uditkalapurakkal/riscv-pipelined-soc-vhdl/riscv-pipelined-soc-vhdl/docs/images/layout_screenshot.png

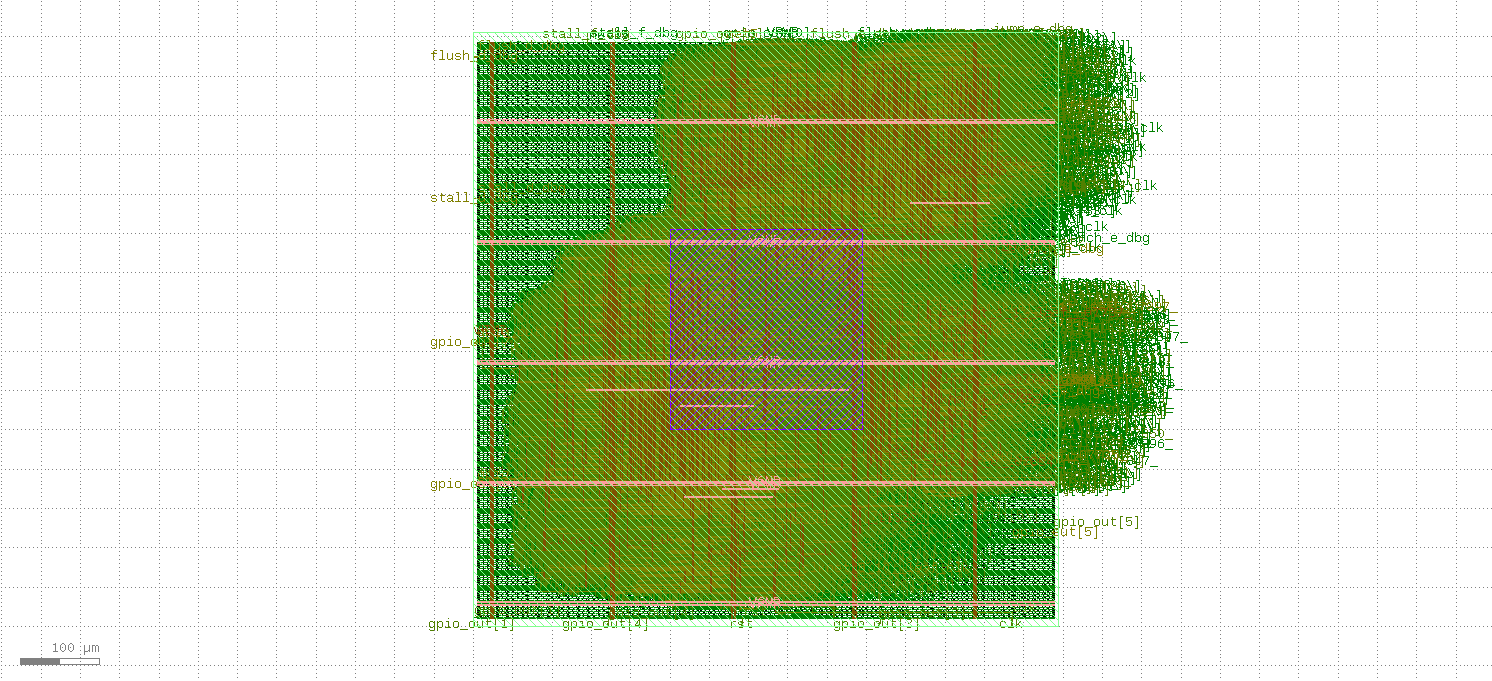
riscv-pipelined-soc-vhdl/docs/images/layout_screenshot.png
