uditkalapurakkal/riscv-pipelined-soc-vhdl/riscv-pipelined-soc-vhdl/reports/openlane/fix_cts_cluster_6/metrics.csv

design | design_name | config | flow_status | total_runtime | routed_runtime | (Cell/mm^2)/Core_Util | DIEAREA_mm^2 | CellPer_mm^2 | OpenDP_Util | Final_Util | Peak_Memory_Usage_MB | synth_cell_count | tritonRoute_violations | Short_violations | MetSpc_violations | OffGrid_violations | MinHole_violations | Other_violations | Magic_violations | pin_antenna_violations | net_antenna_violations | lvs_total_errors | cvc_total_errors | klayout_violations | wire_length | vias | wns | pl_wns | optimized_wns | fastroute_wns | spef_wns | tns | pl_tns | optimized_tns | fastroute_tns | spef_tns | HPWL | routing_layer1_pct | routing_layer2_pct | routing_layer3_pct | routing_layer4_pct | routing_layer5_pct | routing_layer6_pct | wires_count | wire_bits | public_wires_count | public_wire_bits | memories_count | memory_bits | processes_count | cells_pre_abc | AND | DFF | NAND | NOR | OR | XOR | XNOR | MUX
/home/ukm/asic_projects/riscv-pipelined-soc-vhdl/riscv-pipelined-soc-vhdl/openlane/riscv_soc | soc_top | fix_cts_cluster_6 | flow completed | 0h35m52s0ms | 0h29m32s0ms | 113959.51296703656 | 0.5542068513000001 | 39885.82953846279 | 35.88 | -1 | 2039.72 | 17159 | 0 | 0 | 0 | 0 | 0 | 0 | 0 | 24 | 22 | 0 | -1 | -1 | 739391 | 149528 | 0.0 | -1 | -1 | -1 | 0.0 | 0.0 | -1 | -1 | -1 | 0.0 | 491268174.0 | 0.0 | 37.32 | 36.55 | 11.24 | 15.45 | 0.0 | 8255 | 23750 | 1146 | 16583 | 0 | 0 | 0 | 11339 | 244 | 2 | 134 | 167 | 736 | 157 | 109 | 3192
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
