uditkalapurakkal/riscv-pipelined-soc-vhdl/riscv-pipelined-soc-vhdl/waves/BUSCHECK.pdf

0 | 1 | 2 | 4 | 8 | 1 | 2 | 4 | 8 | 1 | 2 | 4 | 8 | 1 | 2 | 4 | 8 | 1 | 2 | 4 | 8 | 1 | 2 | 4 | 8 | 1 | 2 | 4 | 8 | 1

# clk

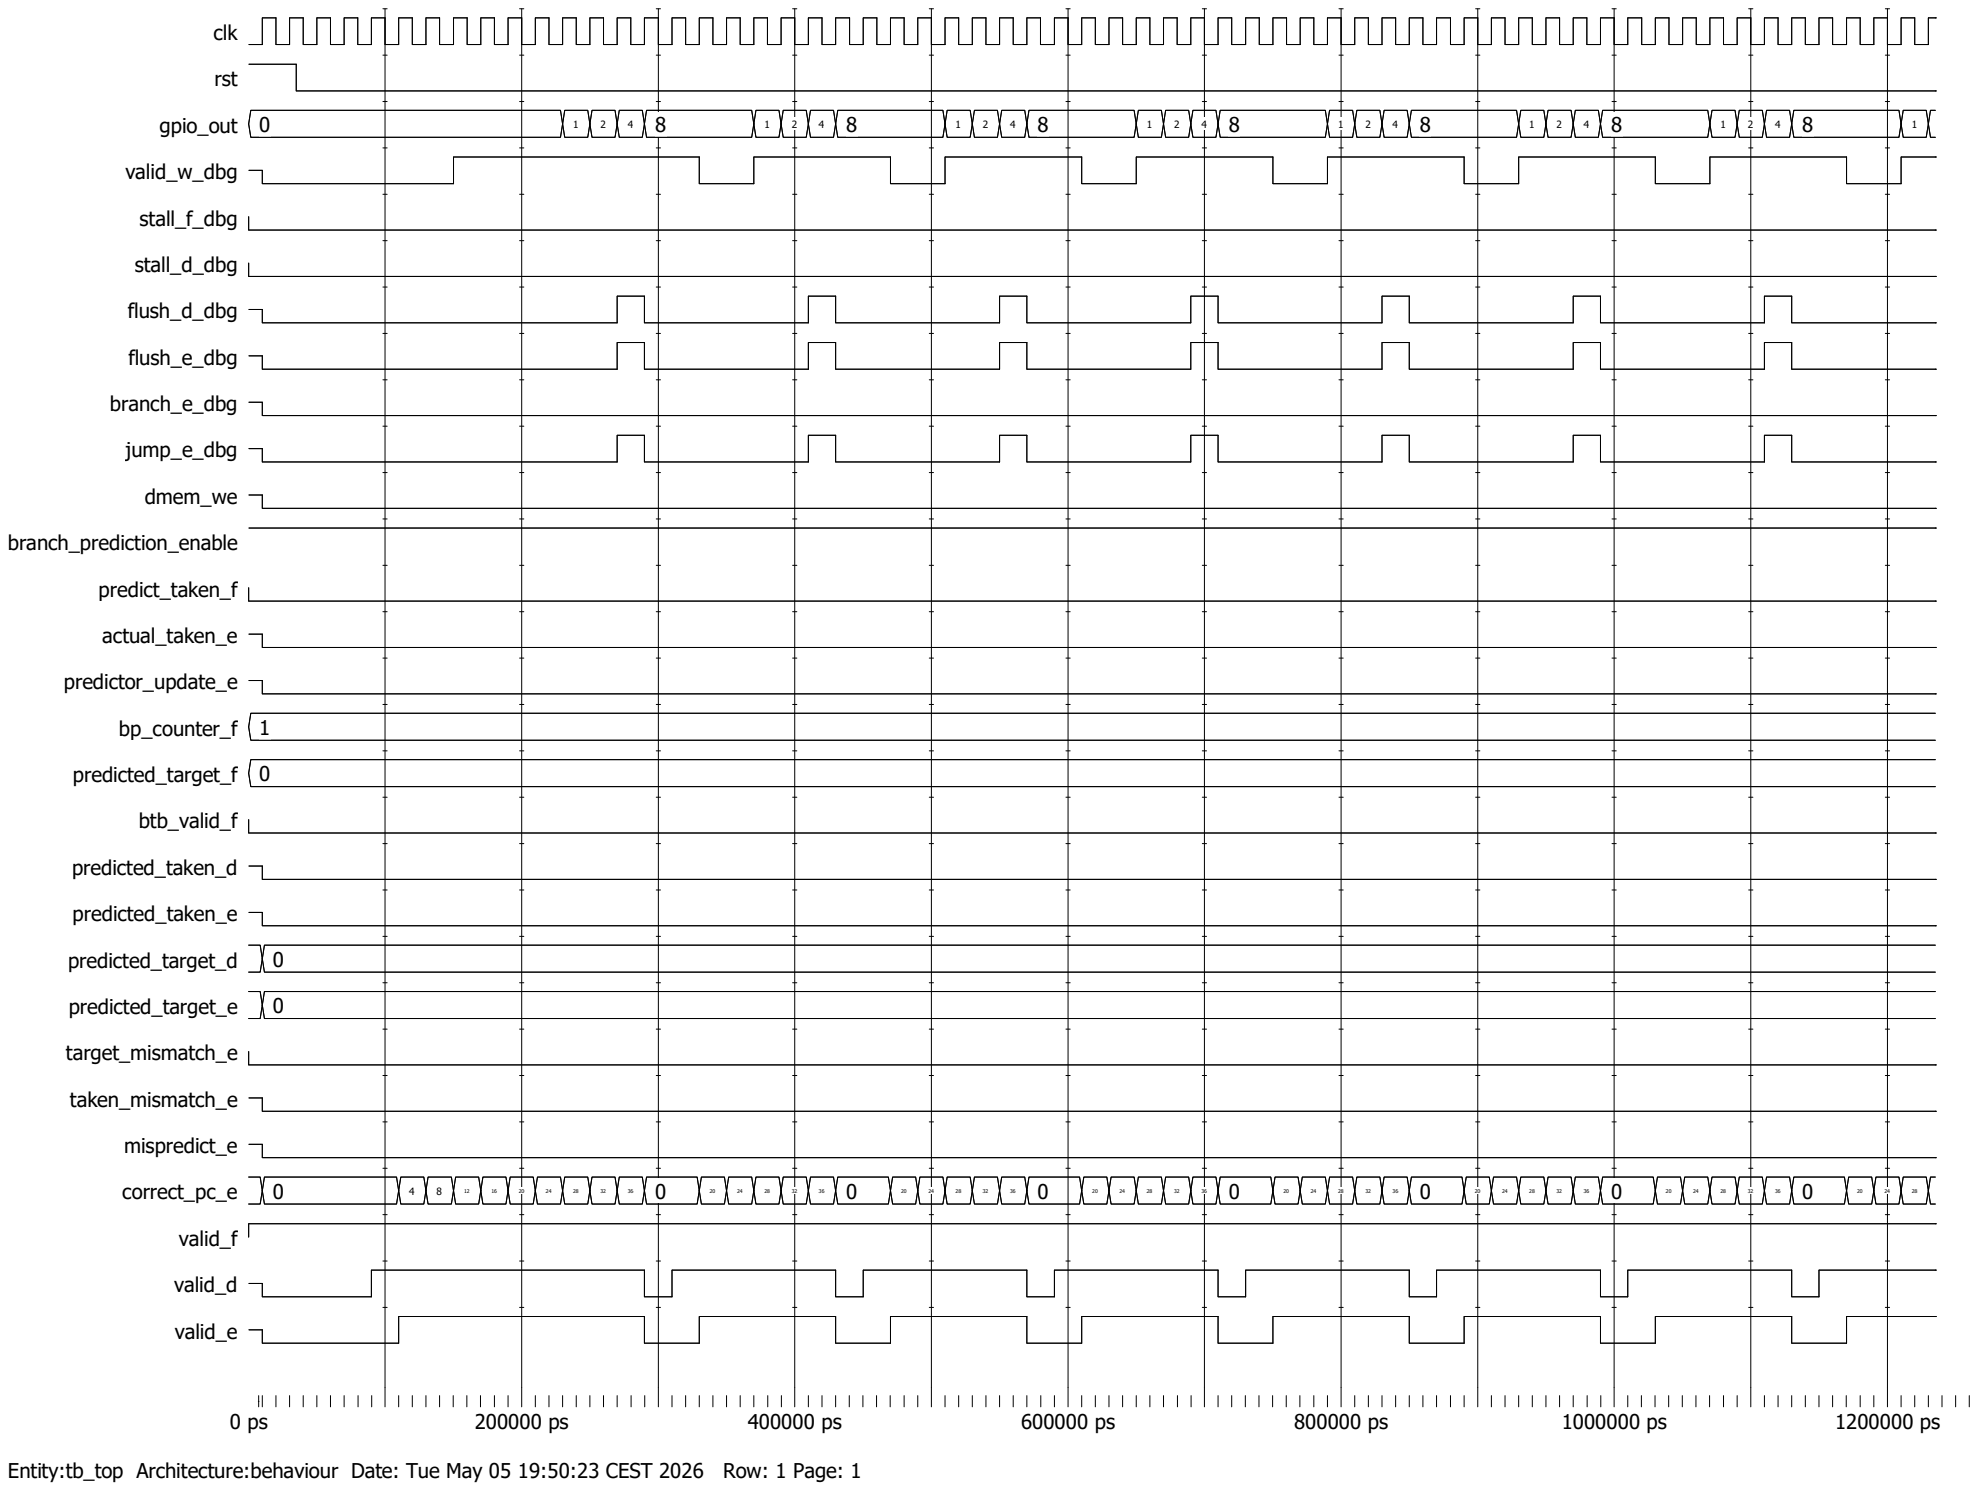
[picture p2: page 1]
rst; gpio_out 0; valid_w_dbg; stall_f_dbg; stall_d_dbg; flush_d_dbg; flush_e_dbg; branch_e_dbg; jump_e_dbg; dmem_we; branch_prediction_enable; predict_taken_f; actual_taken_e; predictor_update_e; bp_counter_f 1; predicted_target_f 0; btb_valid_f; predicted_taken_d; predicted_taken_e; predicted_target_d; predicted_target_e; target_mismatch_e; taken_mismatch_e; mispredict_e; correct_pc_e; valid_f; valid_d; valid_e

Entity:tb_top Architecture:behaviour Date: Tue May 05 19:50:23 CEST 2026 Row: 1 Page: 1

# valid_m

# valid_w

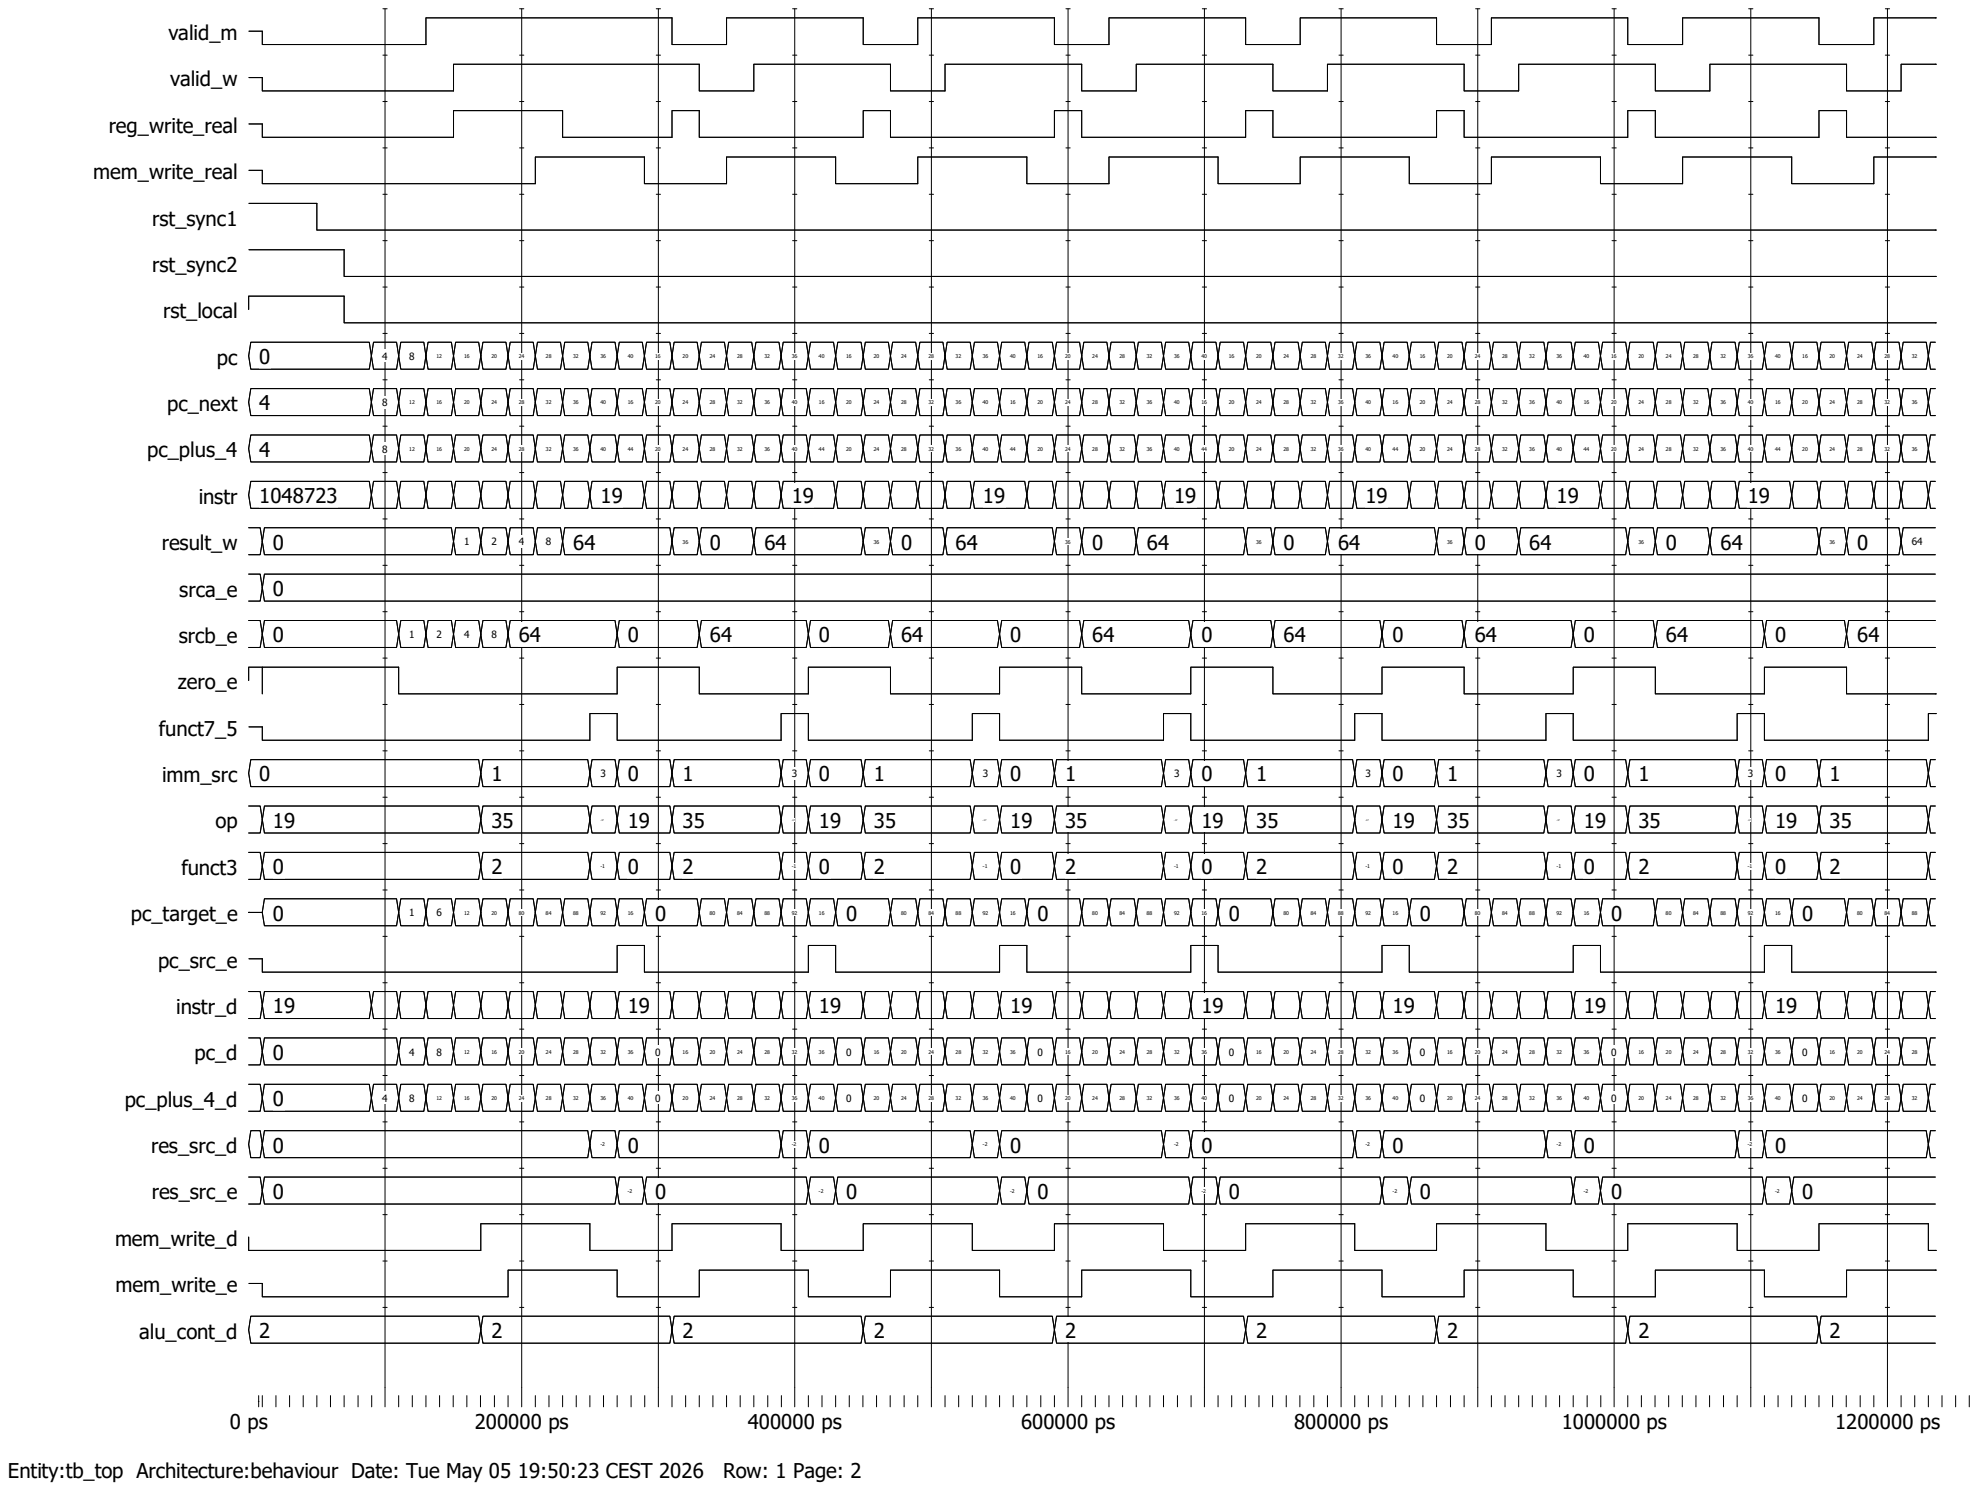
[picture p3: page 2]
reg_write_real; mem_write_real; rst_sync1; rst_sync2; rst_local; pc_next 4; pc_plus_4 4; instr 1048723; result_w; srca_e; srcb_e; zero_e; funct7_5; imm_src 0; funct3; pc_target_e; pc_src_e; instr_d; pc_plus_4_d; res_src_d; res_src_e; mem_write_d; mem_write_e; alu_cont_d 2

Entity:tb_top Architecture:behaviour Date: Tue May 05 19:50:23 CEST 2026 Row: 1 Page: 2

0 | 2 | 0 | 2 | 0 | 2 | 0 | 2 | 0 | 2 | 0 | 2 | 0 | 2 | 0 | 2
alu_cont_e | 0 | 2 | 0 | 2 | 0 | 2 | 0 | 2 | 0 | 2 | 0 | 2 | 0 | 2 | 0 | 2

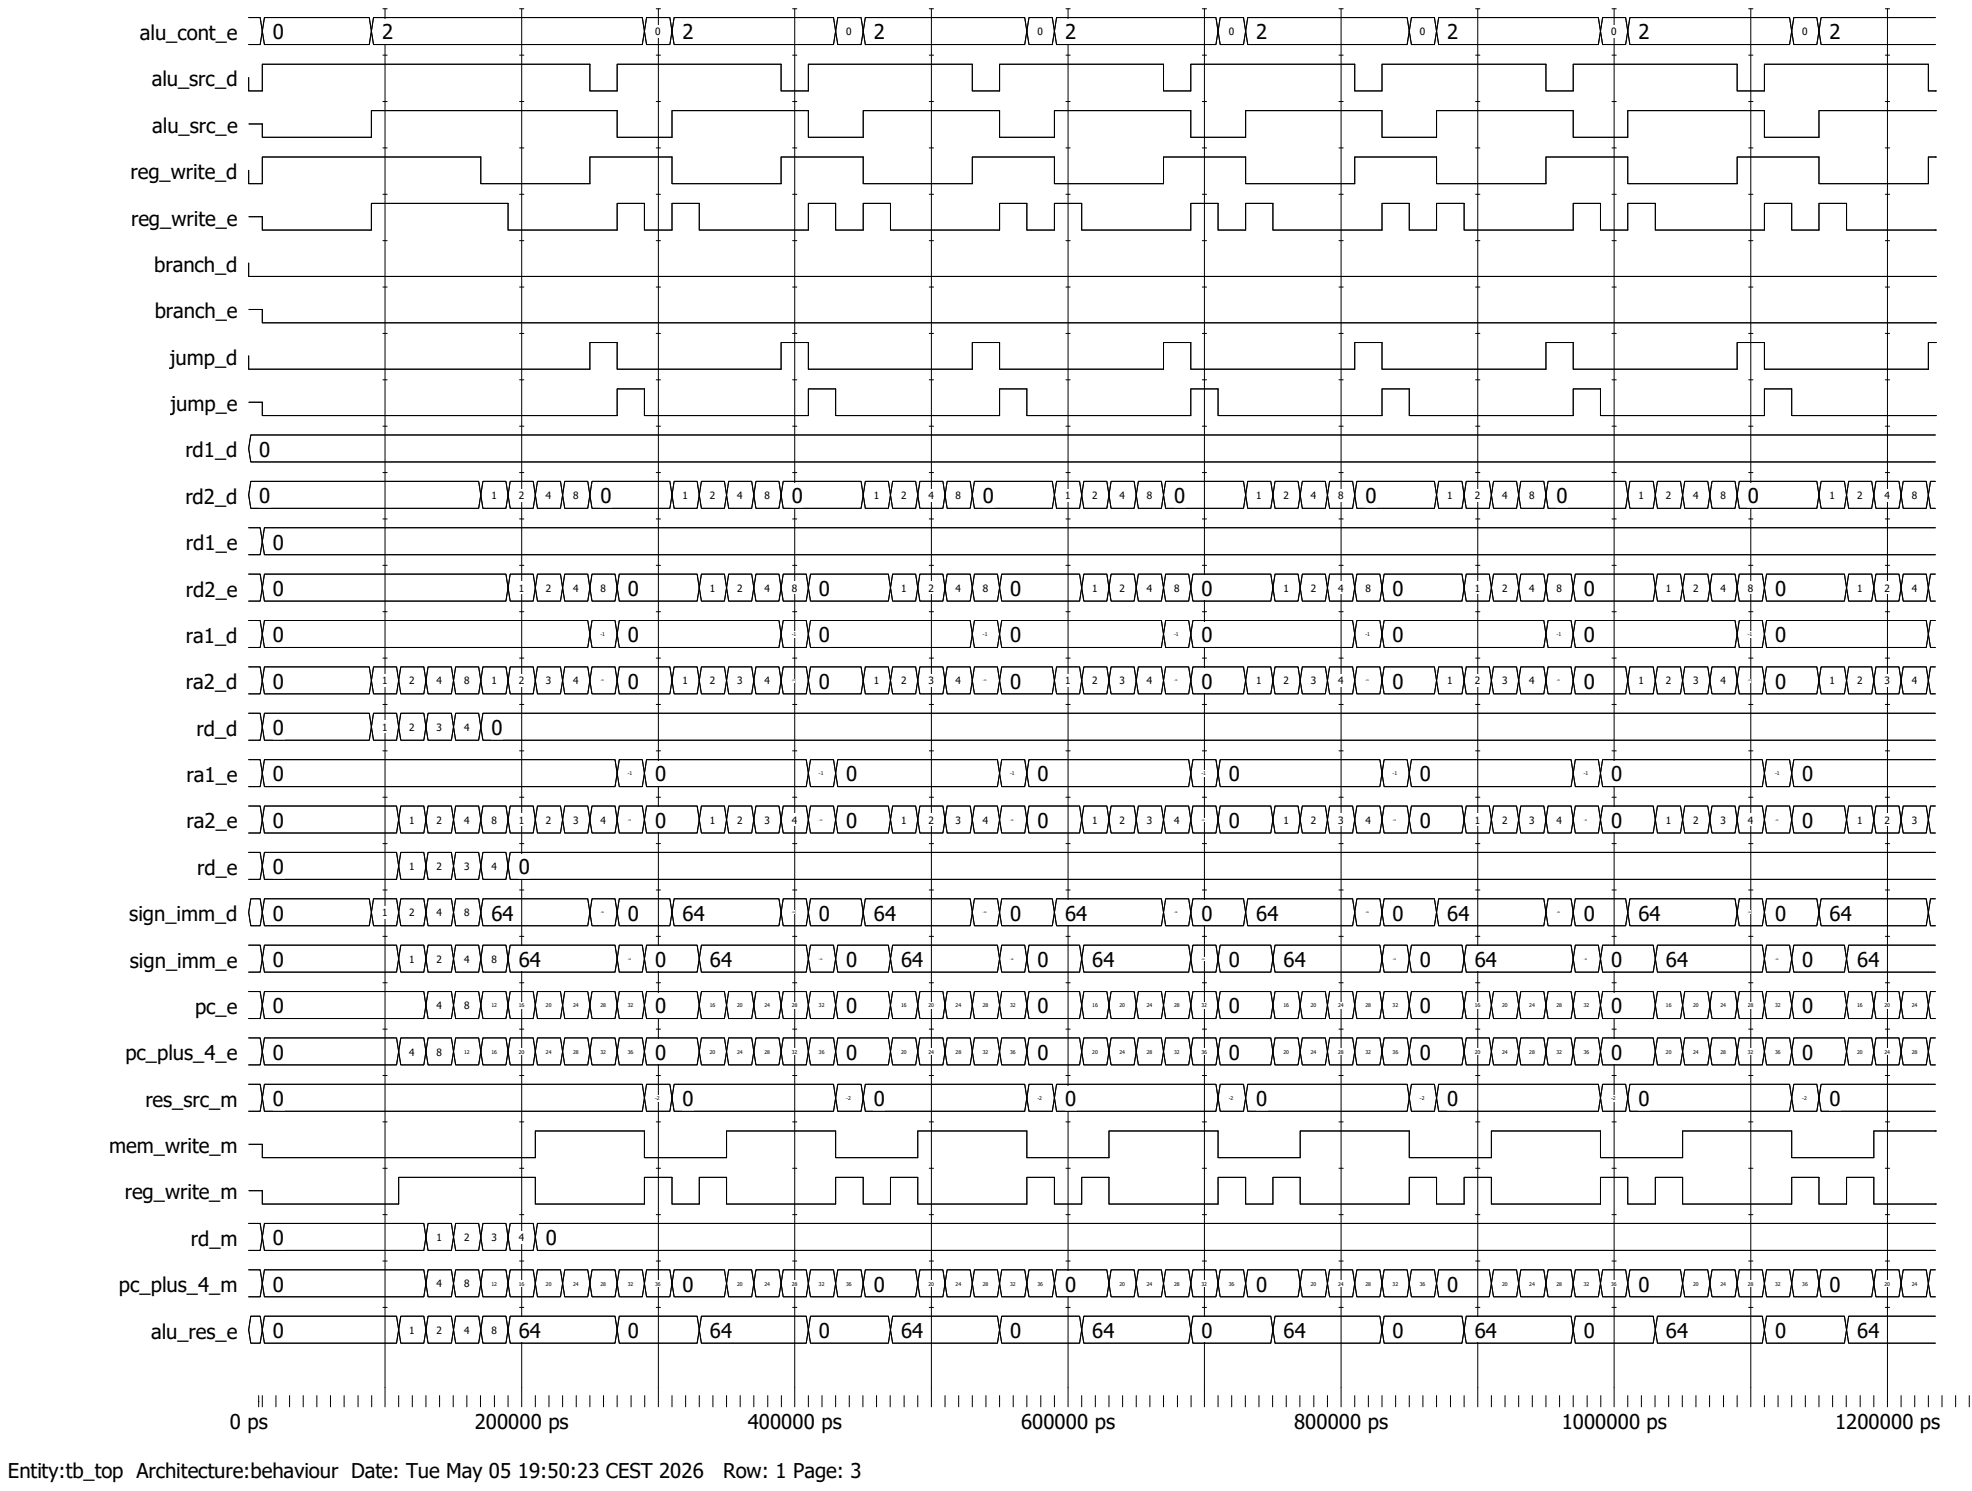
[picture p4: page 3]
alu_src_d; alu_src_e; reg_write_d; reg_write_e; branch_d; branch_e; jump_d; jump_e; sign_imm_d; sign_imm_e; pc_plus_4_e; res_src_m; mem_write_m; reg_write_m; pc_plus_4_m; alu_res_e

Entity:tb_top Architecture:behaviour Date: Tue May 05 19:50:23 CEST 2026 Row: 1 Page: 3

0 | 1 | 2 | 4 | 8 | 64 | 0 | 64 | 0 | 64 | 0 | 64 | 0 | 64 | 0 | 64 | 0 | 64 | 0 | 64
0 | 1 | 2 | 4 | 8 | 0 | 1 | 2 | 4 | 8 | 0 | 1 | 2 | 4 | 8 | 0 | 1 | 2 | 4 | 8 | 0 | 1 | 2 | 4 | 8 | 0 | 1 | 2 | 4 | 8 | 0 | 1 | 2 | 4 | 8 | 0 | 1 | 2 | 4

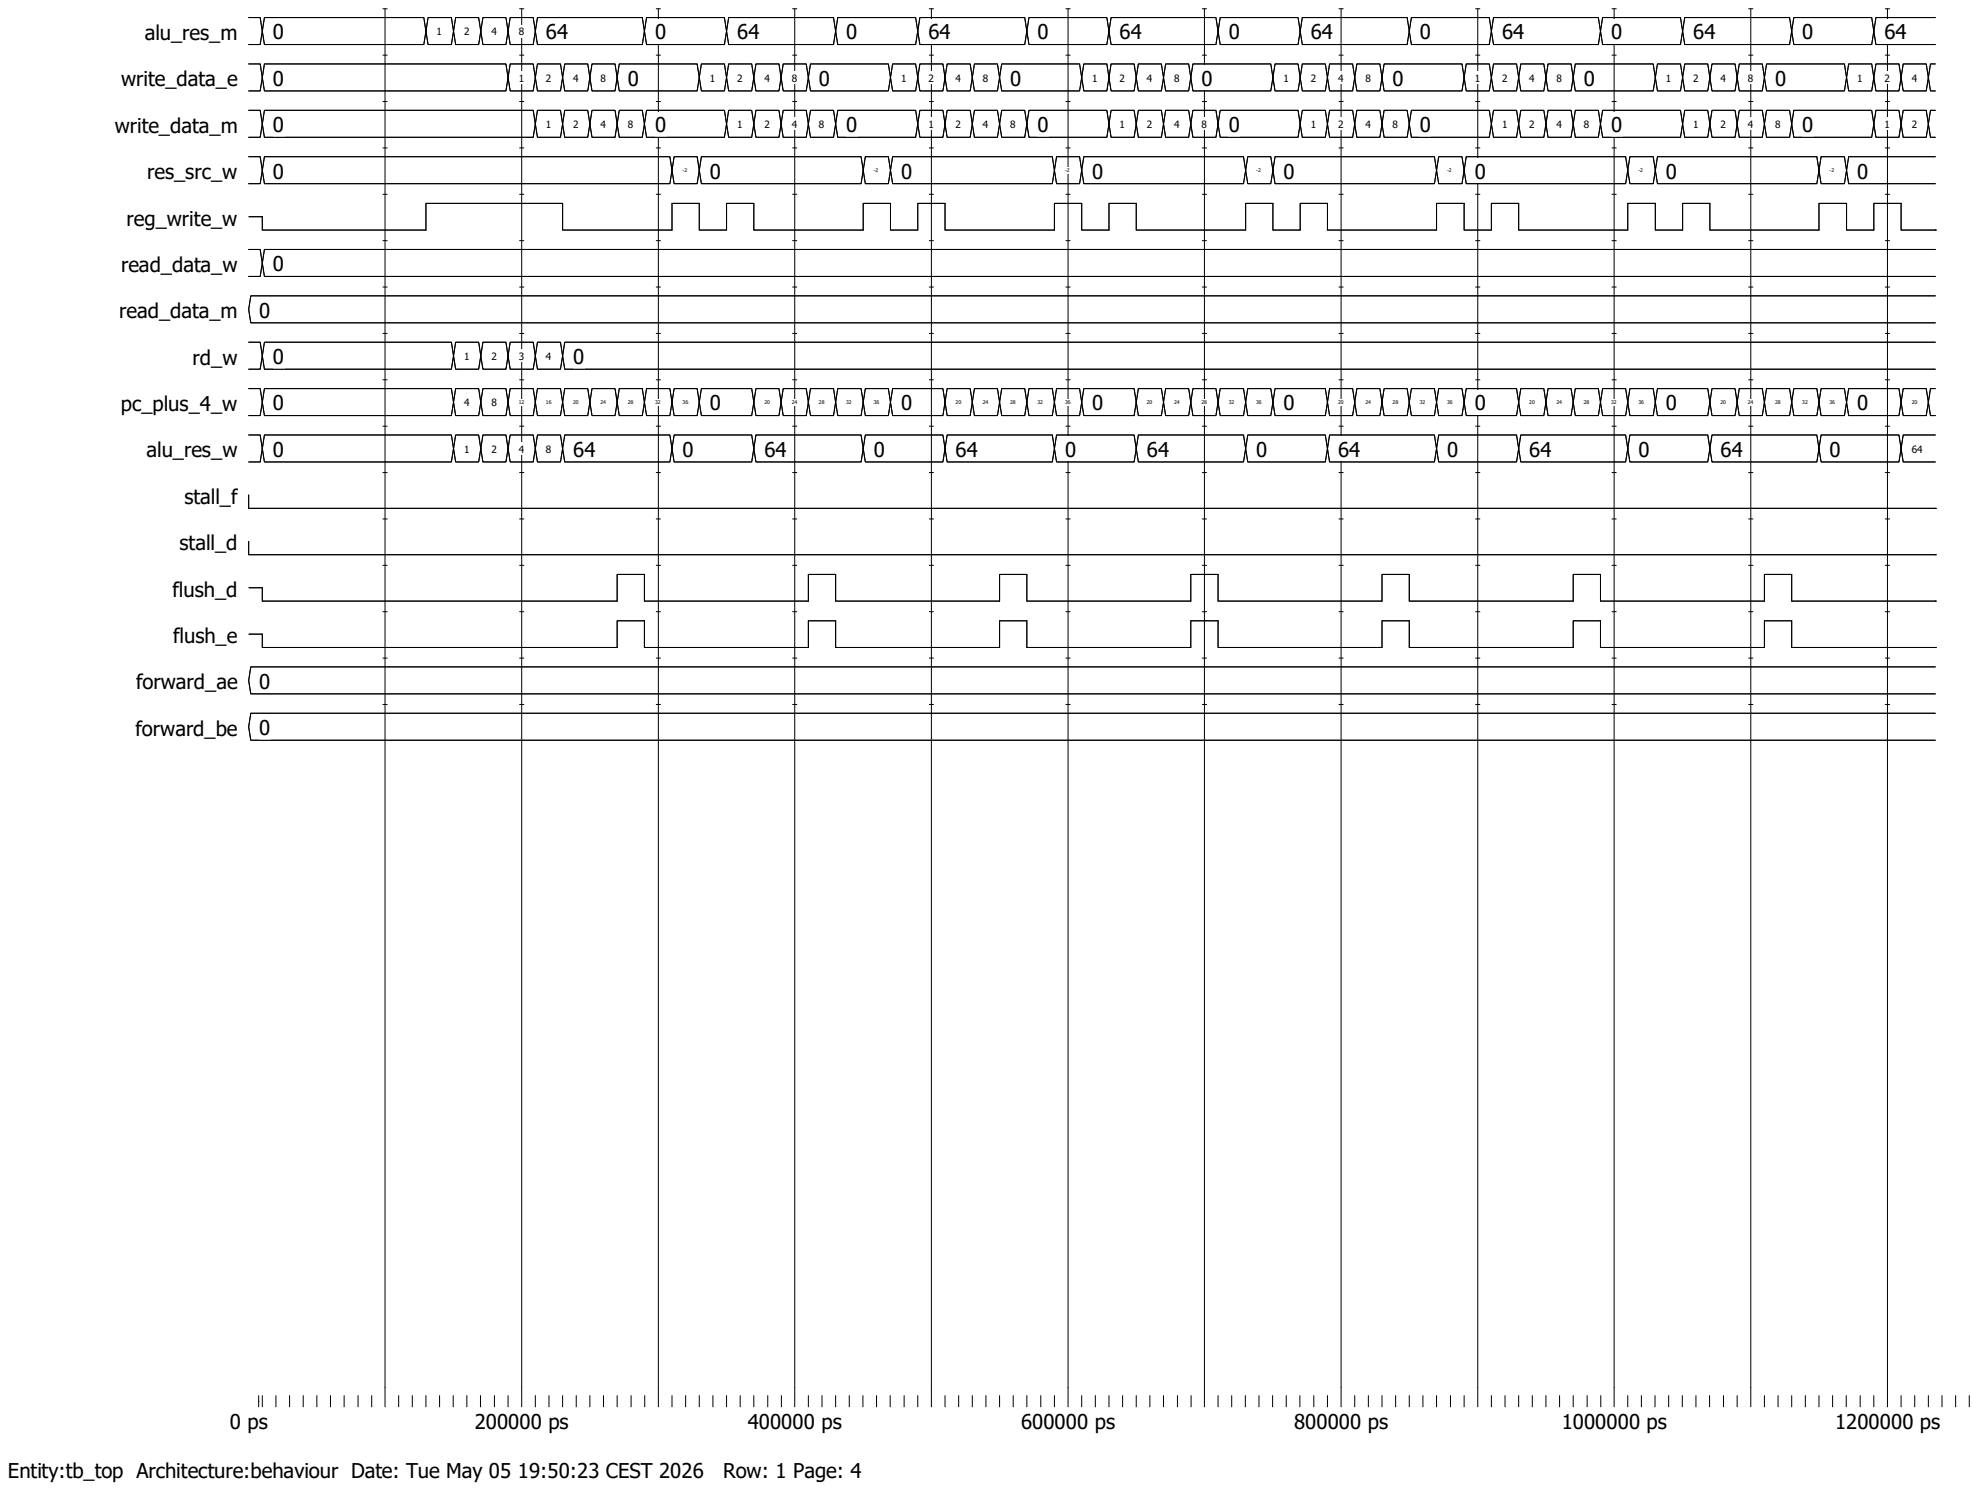
[picture p5: page 4]
alu_res_m; write_data_e; write_data_m; res_src_w; reg_write_w; read_data_w; read_data_m 0; pc_plus_4_w; alu_res_w; stall_f; stall_d; flush_d; flush_e; forward_ae 0; forward_be 0

Entity:tb_top Architecture:behaviour Date: Tue May 05 19:50:23 CEST 2026 Row: 1 Page: 4
