uditkalapurakkal/riscv-pipelined-soc-vhdl/riscv-pipelined-soc-vhdl/waves/rsic_predon.pdf

# clk

# rst

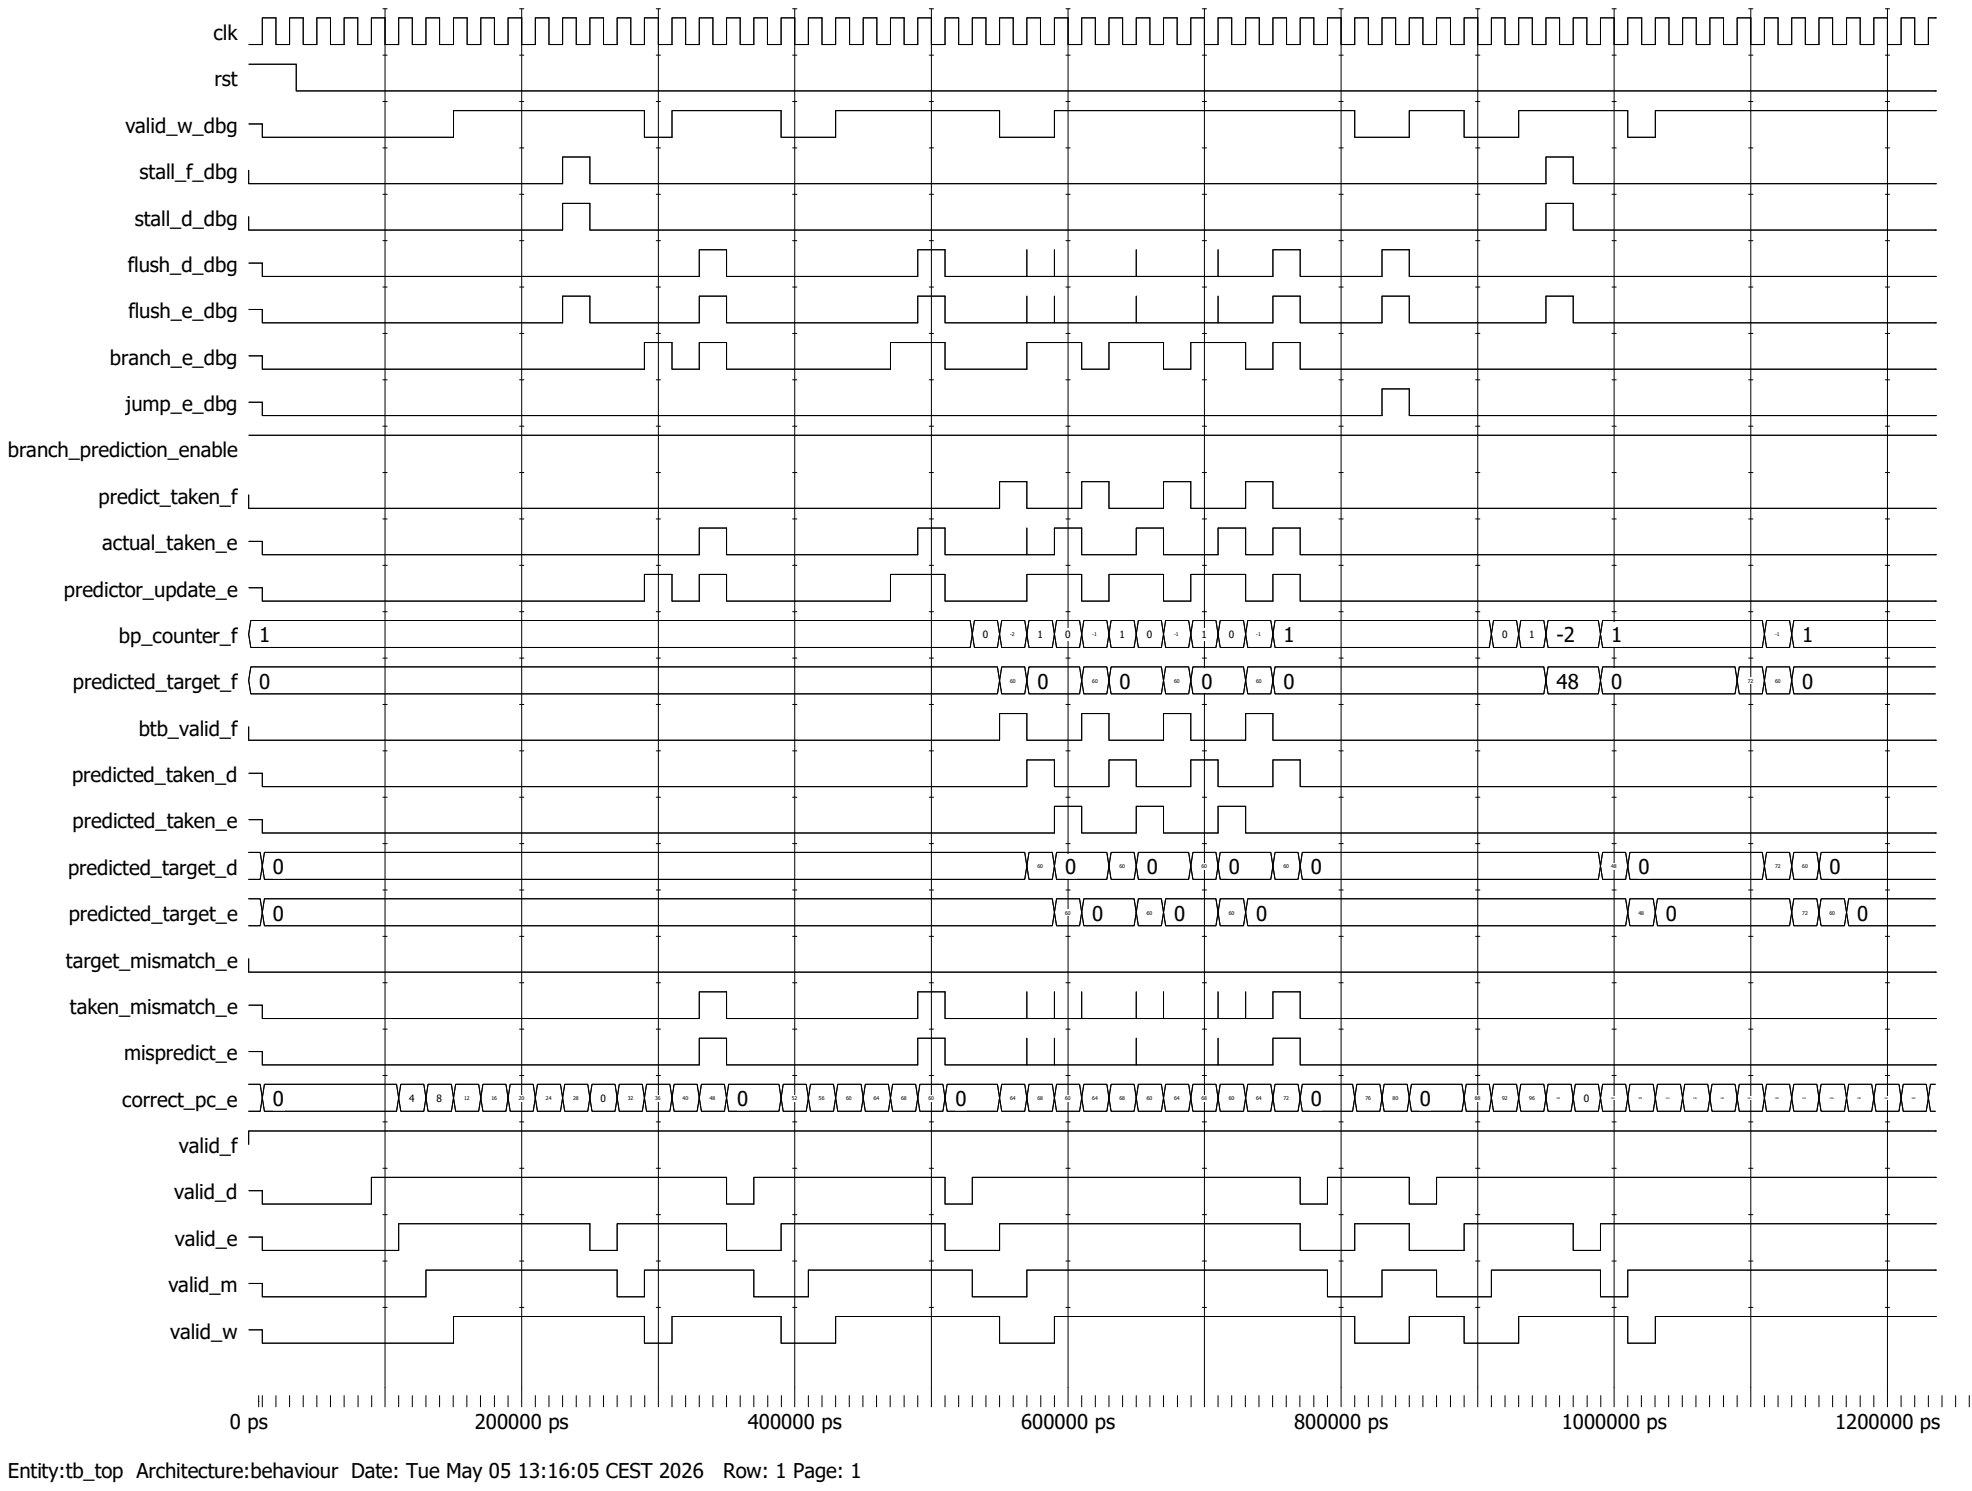
[picture p10: page 1]
valid_w_dbg; stall_f_dbg; stall_d_dbg; flush_d_dbg; flush_e_dbg; branch_e_dbg; jump_e_dbg; branch_prediction_enable; predict_taken_f; actual_taken_e; predictor_update_e; bp_counter_f 1; predicted_target_f 0; btb_valid_f; predicted_taken_d; predicted_taken_e; predicted_target_d; predicted_target_e; target_mismatch_e; taken_mismatch_e; mispredict_e; correct_pc_e; valid_f; valid_d; valid_e; valid_m; valid_w

Entity:tb_top Architecture:behaviour Date: Tue May 05 13:16:05 CEST 2026 Row: 1 Page: 1

00000000000000000000000000000000

00000000000000000000000000000100

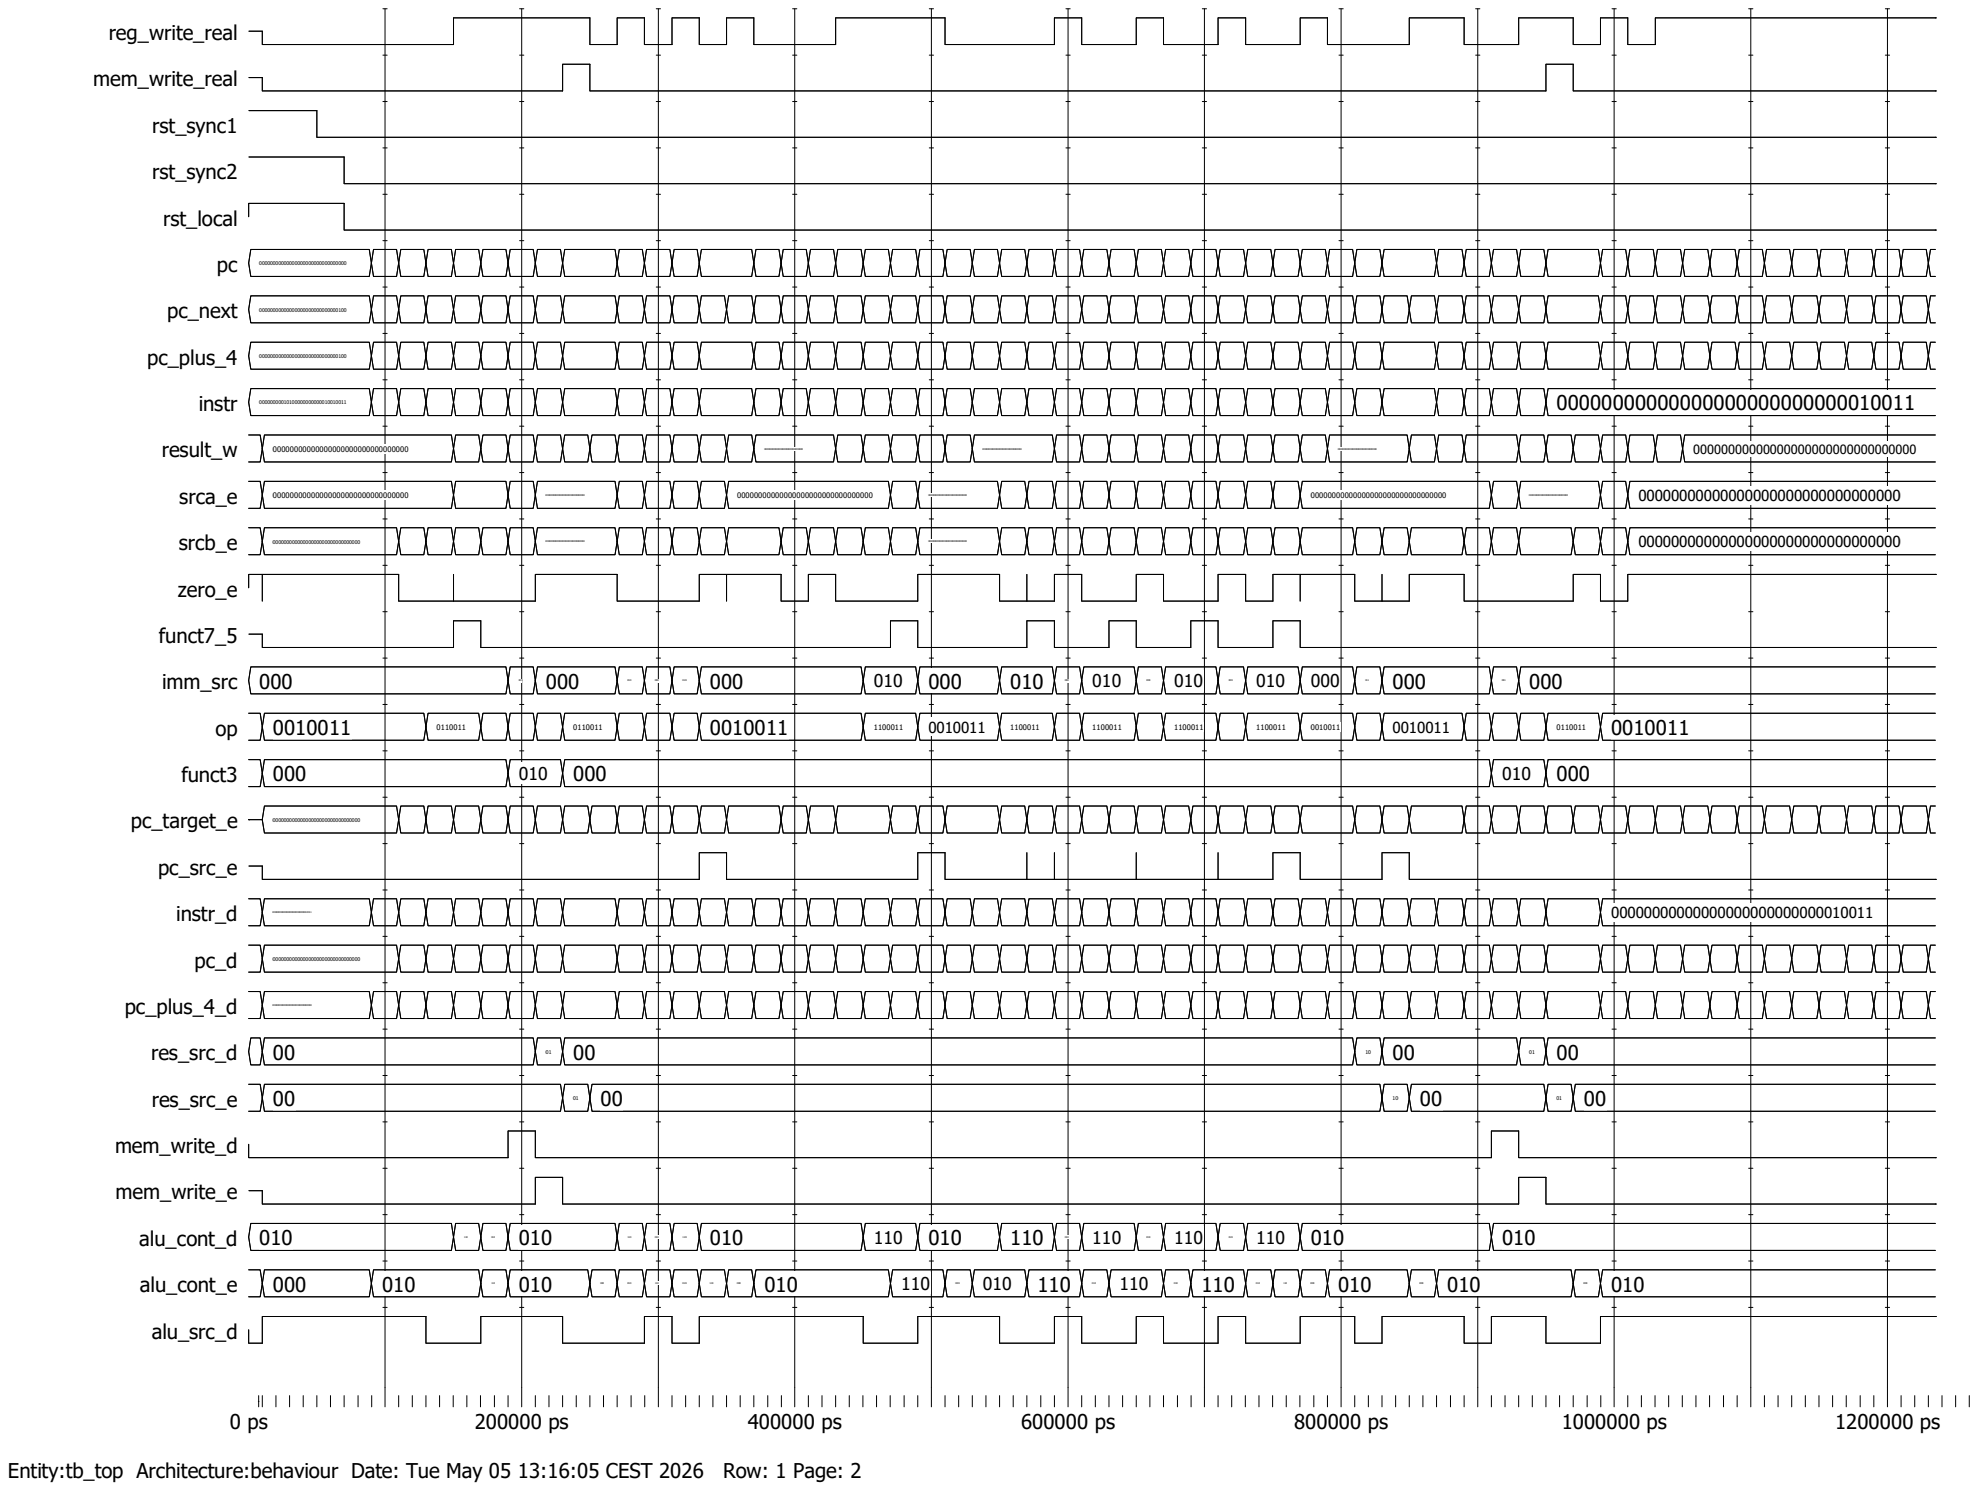
[picture p11: page 2]
reg_write_real; mem_write_real; rst_sync1; rst_sync2; rst_local; pc_next 00000000000000000000000000000100; pc_plus_4 00000000000000000000000000000100; instr 00000000010100000000000010010011; result_w; srca_e; srcb_e; zero_e; funct7_5; imm_src 000; funct3; pc_target_e; pc_src_e; instr_d; pc_plus_4_d; res_src_d; res_src_e; mem_write_d; mem_write_e; alu_cont_d 010; alu_cont_e; alu_src_d

Entity:tb_top Architecture:behaviour Date: Tue May 05 13:16:05 CEST 2026 Row: 1 Page: 2

00000000000000000000000000000000 | 00000000000000000000000000000000 | 00000000000000000000000000000000 | 00000000000000000000000000000000

# alu_src_e

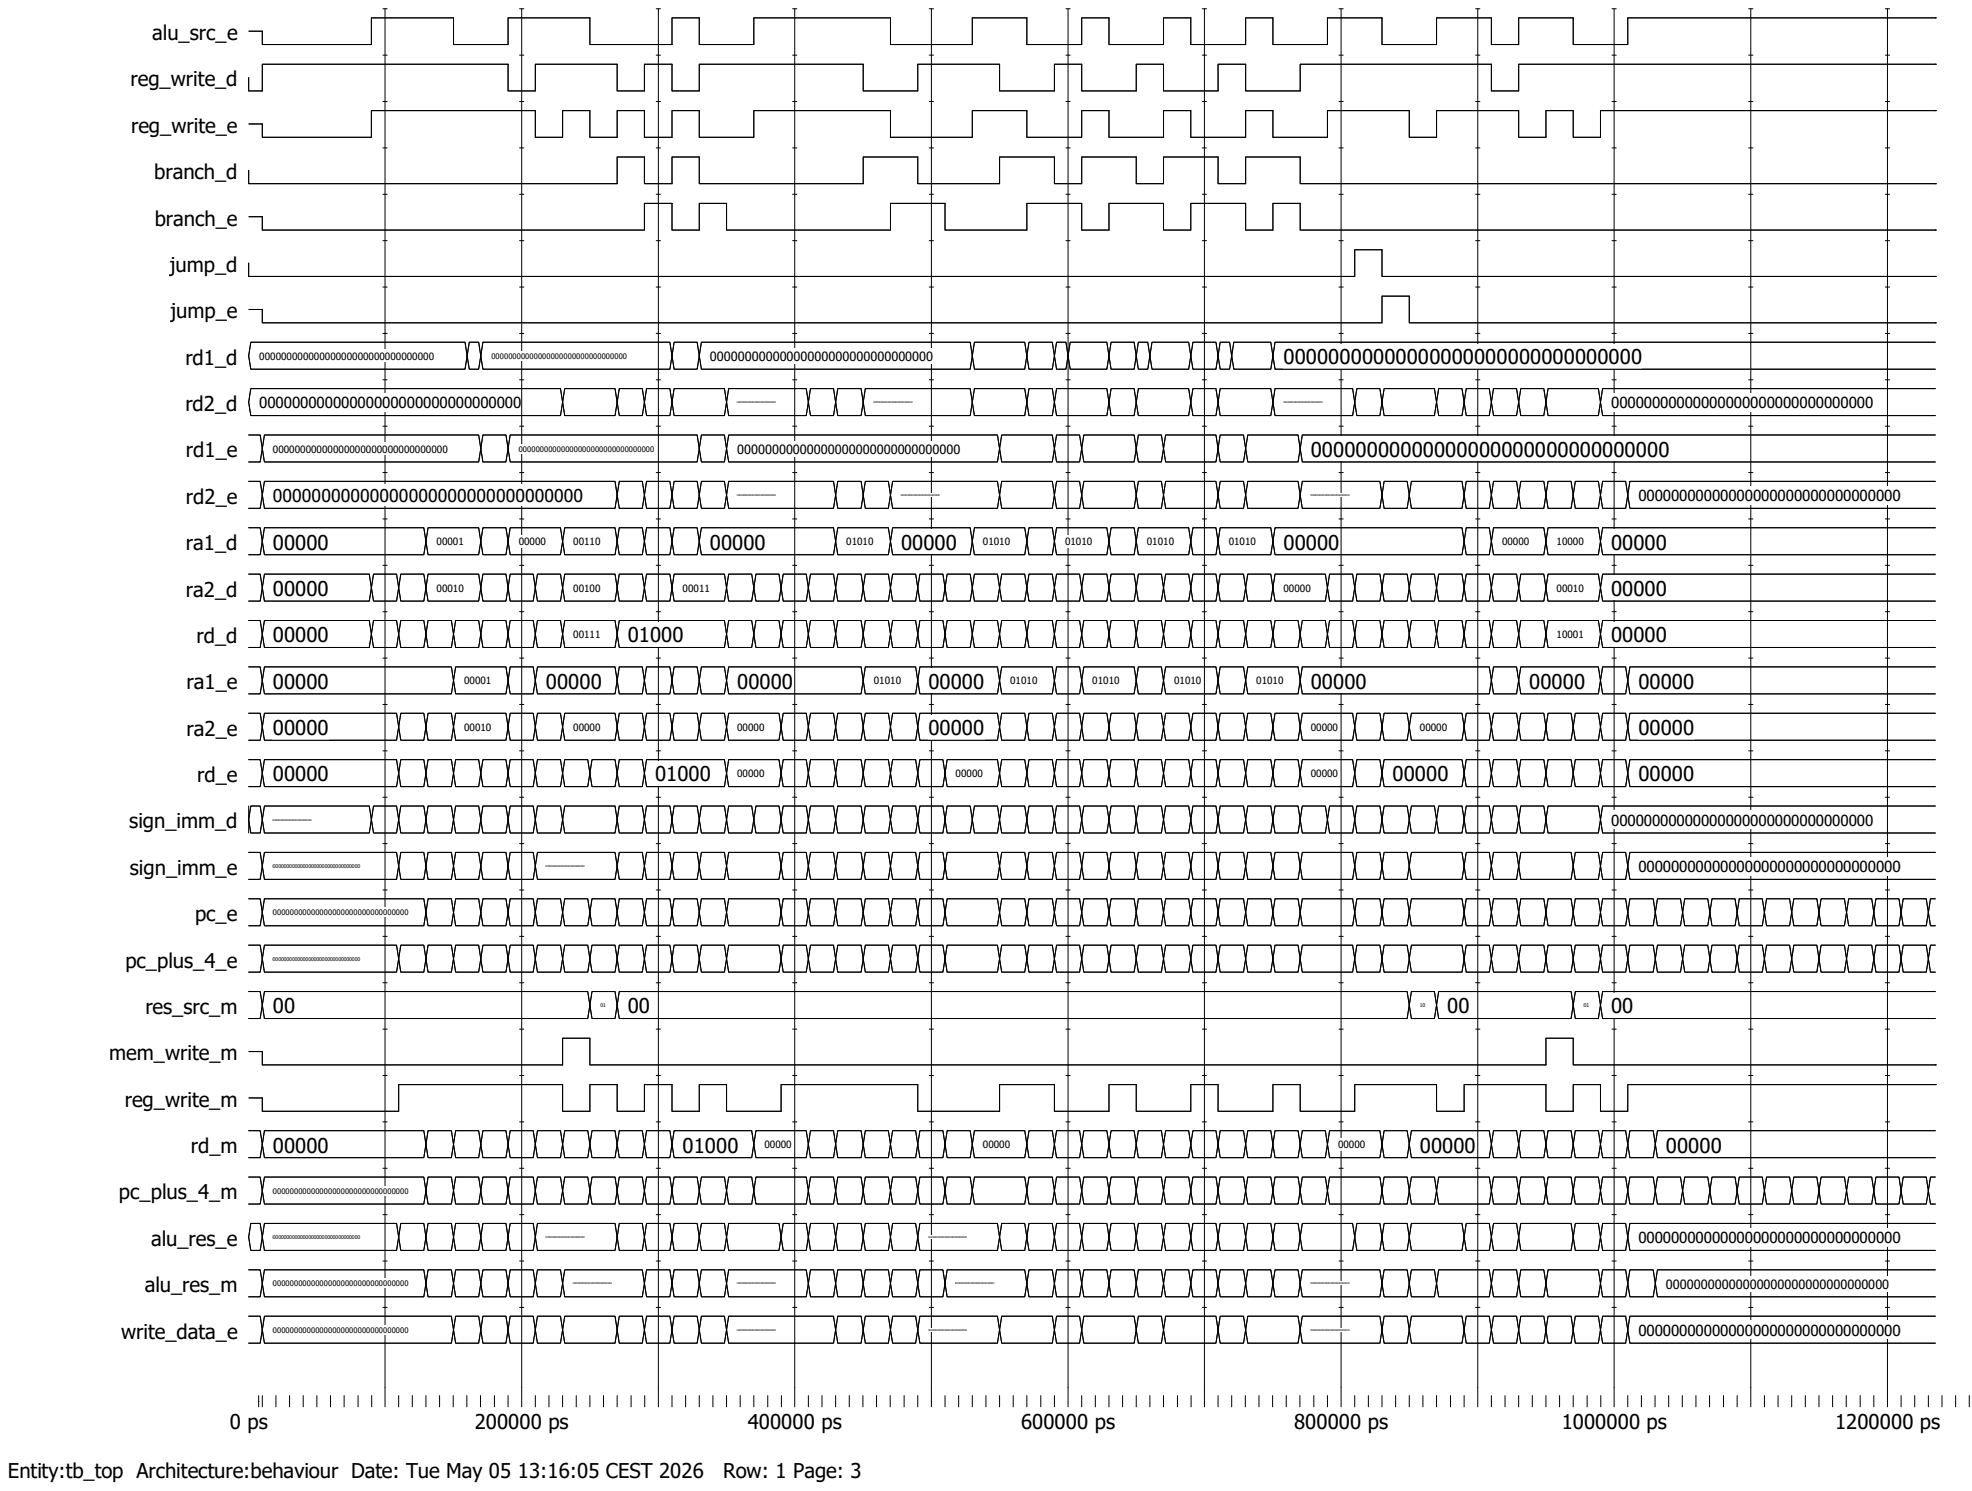
[picture p12: page 3]
reg_write_d; reg_write_e; branch_d; branch_e; jump_d; jump_e; sign_imm_d; sign_imm_e; pc_plus_4_e; res_src_m; mem_write_m; reg_write_m; pc_plus_4_m; alu_res_e; alu_res_m; write_data_e

Entity:tb_top Architecture:behaviour Date: Tue May 05 13:16:05 CEST 2026 Row: 1 Page: 3

00 | 01 | 00 | 10 | 00 | 01 | 00
00000 | 01000 00000 | 00000 | 00000 | 00000 | 00000

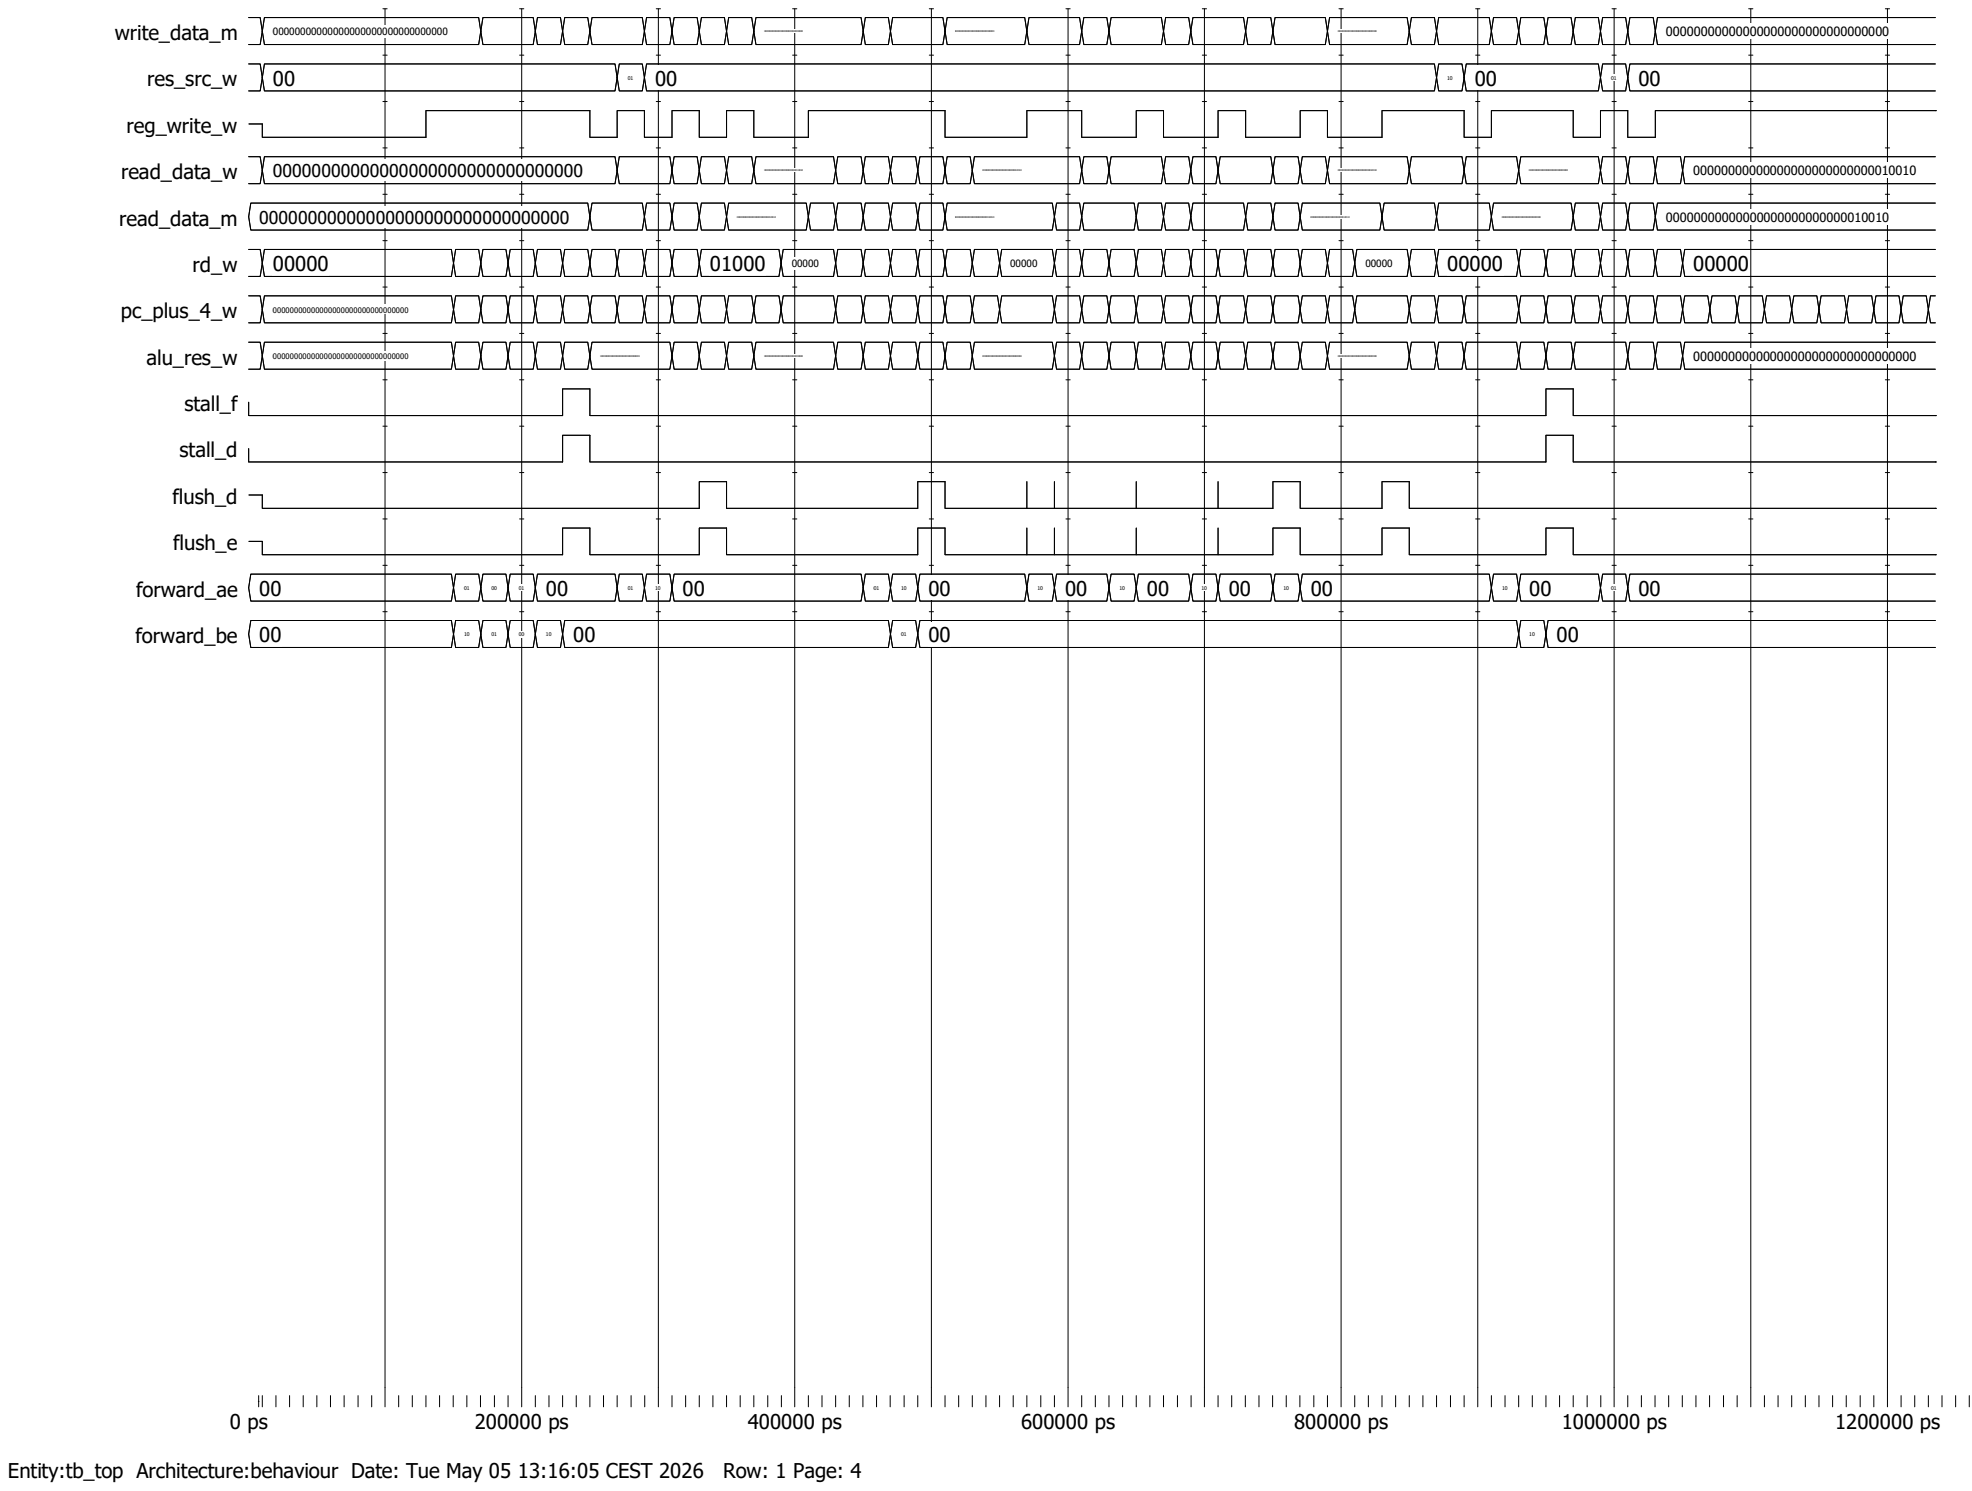
[picture p13: page 4]
write_data_m; res_src_w; reg_write_w; read_data_w; read_data_m 00000000000000000000000000000000; pc_plus_4_w; alu_res_w; stall_f; stall_d; flush_d; flush_e; forward_ae 00; forward_be 00

Entity:tb_top Architecture:behaviour Date: Tue May 05 13:16:05 CEST 2026 Row: 1 Page: 4
