uditkalapurakkal/riscv-pipelined-soc-vhdl/riscv-pipelined-soc-vhdl/rtl/top_synth.v

module alu_decoder
  (input  [2:0] funct3,
   input  funct7_5,
   input  op5,
   input  [1:0] alu_op,
   output [2:0] alu_cont);
  wire n2262_o;
  wire n2264_o;
  wire n2265_o;
  wire [2:0] n2268_o;
  wire n2270_o;
  wire n2272_o;
  wire n2274_o;
  wire n2276_o;
  wire [3:0] n2277_o;
  reg [2:0] n2282_o;
  wire n2284_o;
  wire [2:0] n2285_o;
  reg [2:0] n2289_o;
  assign alu_cont = n2289_o; //(module output)
  /* ALU_DECODER.vhd:21:7  */
  assign n2262_o = alu_op == 2'b00;
  /* ALU_DECODER.vhd:23:7  */
  assign n2264_o = alu_op == 2'b01;
  /* ALU_DECODER.vhd:28:26  */
  assign n2265_o = funct7_5 & op5;
  /* ALU_DECODER.vhd:28:13  */
  assign n2268_o = n2265_o ? 3'b110 : 3'b010;
  /* ALU_DECODER.vhd:27:11  */
  assign n2270_o = funct3 == 3'b000;
  /* ALU_DECODER.vhd:33:11  */
  assign n2272_o = funct3 == 3'b010;
  /* ALU_DECODER.vhd:35:11  */
  assign n2274_o = funct3 == 3'b110;
  /* ALU_DECODER.vhd:37:11  */
  assign n2276_o = funct3 == 3'b111;
  assign n2277_o = {n2276_o, n2274_o, n2272_o, n2270_o};
  /* ALU_DECODER.vhd:26:9  */
  always @*
    case (n2277_o)
      4'b1000: n2282_o = 3'b000;
      4'b0100: n2282_o = 3'b001;
      4'b0010: n2282_o = 3'b111;
      4'b0001: n2282_o = n2268_o;
      default: n2282_o = 3'b010;
    endcase
  /* ALU_DECODER.vhd:25:7  */
  assign n2284_o = alu_op == 2'b10;
  assign n2285_o = {n2284_o, n2264_o, n2262_o};
  /* ALU_DECODER.vhd:20:5  */
  always @*
    case (n2285_o)
      3'b100: n2289_o = n2282_o;
      3'b010: n2289_o = 3'b110;
      3'b001: n2289_o = 3'b010;
      default: n2289_o = 3'b010;
    endcase
endmodule

module main_decoder
  (input  [6:0] op,
   output [2:0] imm_src,
   output reg_write,
   output [1:0] res_src,
   output alu_src,
   output branch,
   output jump,
   output mem_write,
   output [1:0] alu_op);
  wire n2162_o;
  wire n2164_o;
  wire n2166_o;
  wire n2168_o;
  wire n2170_o;
  wire n2172_o;
  wire n2174_o;
  wire n2176_o;
  wire [7:0] n2177_o;
  reg [2:0] n2187_o;
  reg n2197_o;
  reg [1:0] n2207_o;
  reg n2217_o;
  reg n2227_o;
  reg n2237_o;
  reg n2247_o;
  reg [1:0] n2257_o;
  assign imm_src = n2187_o; //(module output)
  assign reg_write = n2197_o; //(module output)
  assign res_src = n2207_o; //(module output)
  assign alu_src = n2217_o; //(module output)
  assign branch = n2227_o; //(module output)
  assign jump = n2237_o; //(module output)
  assign mem_write = n2247_o; //(module output)
  assign alu_op = n2257_o; //(module output)
  /* MAIN_DECODER.vhd:25:7  */
  assign n2162_o = op == 7'b0110011;
  /* MAIN_DECODER.vhd:34:7  */
  assign n2164_o = op == 7'b0000011;
  /* MAIN_DECODER.vhd:43:7  */
  assign n2166_o = op == 7'b0100011;
  /* MAIN_DECODER.vhd:52:7  */
  assign n2168_o = op == 7'b1100011;
  /* MAIN_DECODER.vhd:61:7  */
  assign n2170_o = op == 7'b0010011;
  /* MAIN_DECODER.vhd:70:7  */
  assign n2172_o = op == 7'b1101111;
  /* MAIN_DECODER.vhd:79:7  */
  assign n2174_o = op == 7'b0110111;
  /* MAIN_DECODER.vhd:88:7  */
  assign n2176_o = op == 7'b0010111;
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
      8'b00100000: n2257_o = 2'b00;
      8'b00010000: n2257_o = 2'b10;
      8'b00001000: n2257_o = 2'b01;
      8'b00000100: n2257_o = 2'b00;
      8'b00000010: n2257_o = 2'b00;
      8'b00000001: n2257_o = 2'b10;
      default: n2257_o = 2'b00;
    endcase
endmodule

module bus_m
  (input  clk,
   input  rst,
   input  mem_we,
   input  [31:0] addr,
   input  [31:0] write_data,
   output dmem_we,
   output [7:0] gpio_out);
  reg [7:0] gpio_reg;
  wire gpio_sel;
  wire gpio_we;
  wire n2136_o;
  wire n2137_o;
  wire n2139_o;
  wire n2140_o;
  wire n2141_o;
  wire [7:0] n2145_o;
  wire [7:0] n2146_o;
  wire [7:0] n2148_o;
  reg [7:0] n2151_q;
  assign dmem_we = n2141_o; //(module output)
  assign gpio_out = gpio_reg; //(module output)
  /* BUS.vhd:25:8  */
  always @*
    gpio_reg = n2151_q; // (isignal)
  initial
    gpio_reg = 8'b00000000;
  /* BUS.vhd:27:8  */
  assign gpio_sel = n2137_o; // (signal)
  /* BUS.vhd:28:8  */
  assign gpio_we = n2139_o; // (signal)
  /* BUS.vhd:34:27  */
  assign n2136_o = addr == 32'b00000000000000000000000001000000;
  /* BUS.vhd:34:17  */
  assign n2137_o = n2136_o ? 1'b1 : 1'b0;
  /* BUS.vhd:37:19  */
  assign n2139_o = mem_we & gpio_sel;
  /* BUS.vhd:38:23  */
  assign n2140_o = ~gpio_sel;
  /* BUS.vhd:38:19  */
  assign n2141_o = mem_we & n2140_o;
  /* BUS.vhd:48:29  */
  assign n2145_o = write_data[7:0]; // extract
  /* BUS.vhd:47:5  */
  assign n2146_o = gpio_we ? n2145_o : gpio_reg;
  /* BUS.vhd:44:5  */
  assign n2148_o = rst ? 8'b00000000 : n2146_o;
  /* BUS.vhd:43:3  */
  always @(posedge clk)
    n2151_q <= n2148_o;
  initial
    n2151_q = 8'b00000000;
endmodule

module branch_pred
  (input  clk,
   input  rst,
   input  [31:0] pc_f,
   input  [31:0] pc_e,
   input  actual_taken_e,
   input  update_en_e,
   input  [31:0] actual_target_e,
   output predict_taken_f,
   output [1:0] debug_counter_f,
   output [31:0] predicted_target_f,
   output btb_valid_f);
  reg [31:0] bht;
  wire [3:0] index_f;
  wire [3:0] index_e;
  reg [511:0] btb;
  reg [15:0] btb_valid;
  reg [511:0] btb_tag;
  wire btb_hit_f;
  wire [3:0] n906_o;
  wire [3:0] n908_o;
  wire [3:0] n911_o;
  wire [3:0] n918_o;
  wire n921_o;
  wire n922_o;
  wire n923_o;
  wire [3:0] n926_o;
  wire n929_o;
  wire [3:0] n931_o;
  wire [3:0] n937_o;
  wire [3:0] n941_o;
  wire n946_o;
  wire [3:0] n948_o;
  wire n953_o;
  wire [3:0] n955_o;
  wire n960_o;
  wire [3:0] n962_o;
  wire n967_o;
  wire [3:0] n969_o;
  wire [3:0] n973_o;
  reg [31:0] n974_o;
  wire [3:0] n976_o;
  wire [3:0] n980_o;
  wire n986_o;
  wire [3:0] n988_o;
  wire [3:0] n992_o;
  wire n997_o;
  wire [3:0] n999_o;
  wire n1004_o;
  wire [3:0] n1006_o;
  wire n1011_o;
  wire [3:0] n1013_o;
  wire n1018_o;
  wire [3:0] n1020_o;
  wire [3:0] n1024_o;
  reg [31:0] n1025_o;
  wire [31:0] n1026_o;
  wire [31:0] n1027_o;
  wire [511:0] n1028_o;
  wire [15:0] n1029_o;
  wire [511:0] n1030_o;
  wire [31:0] n1031_o;
  wire n1032_o;
  wire n1033_o;
  wire n1034_o;
  wire [31:0] n1036_o;
  wire [511:0] n1038_o;
  wire [15:0] n1040_o;
  wire [511:0] n1042_o;
  reg [31:0] n1048_q;
  reg [511:0] n1049_q;
  reg [15:0] n1050_q;
  reg [511:0] n1051_q;
  wire [1:0] n1052_o;
  wire [1:0] n1053_o;
  wire [1:0] n1054_o;
  wire [1:0] n1055_o;
  wire [1:0] n1056_o;
  wire [1:0] n1057_o;
  wire [1:0] n1058_o;
  wire [1:0] n1059_o;
  wire [1:0] n1060_o;
  wire [1:0] n1061_o;
  wire [1:0] n1062_o;
  wire [1:0] n1063_o;
  wire [1:0] n1064_o;
  wire [1:0] n1065_o;
  wire [1:0] n1066_o;
  wire [1:0] n1067_o;
  wire [1:0] n1068_o;
  reg [1:0] n1069_o;
  wire [1:0] n1070_o;
  reg [1:0] n1071_o;
  wire [1:0] n1072_o;
  reg [1:0] n1073_o;
  wire [1:0] n1074_o;
  reg [1:0] n1075_o;
  wire [1:0] n1076_o;
  reg [1:0] n1077_o;
  wire n1078_o;
  wire n1079_o;
  wire n1080_o;
  wire n1081_o;
  wire n1082_o;
  wire n1083_o;
  wire n1084_o;
  wire n1085_o;
  wire n1086_o;
  wire n1087_o;
  wire n1088_o;
  wire n1089_o;
  wire n1090_o;
  wire n1091_o;
  wire n1092_o;
  wire n1093_o;
  wire [1:0] n1094_o;
  reg n1095_o;
  wire [1:0] n1096_o;
  reg n1097_o;
  wire [1:0] n1098_o;
  reg n1099_o;
  wire [1:0] n1100_o;
  reg n1101_o;
  wire [1:0] n1102_o;
  reg n1103_o;
  wire [31:0] n1104_o;
  wire [31:0] n1105_o;
  wire [31:0] n1106_o;
  wire [31:0] n1107_o;
  wire [31:0] n1108_o;
  wire [31:0] n1109_o;
  wire [31:0] n1110_o;
  wire [31:0] n1111_o;
  wire [31:0] n1112_o;
  wire [31:0] n1113_o;
  wire [31:0] n1114_o;
  wire [31:0] n1115_o;
  wire [31:0] n1116_o;
  wire [31:0] n1117_o;
  wire [31:0] n1118_o;
  wire [31:0] n1119_o;
  wire [1:0] n1120_o;
  reg [31:0] n1121_o;
  wire [1:0] n1122_o;
  reg [31:0] n1123_o;
  wire [1:0] n1124_o;
  reg [31:0] n1125_o;
  wire [1:0] n1126_o;
  reg [31:0] n1127_o;
  wire [1:0] n1128_o;
  reg [31:0] n1129_o;
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
  assign n2109_o = n2087_o ? 2'b01 : n2108_o;
  assign n2110_o = bht[13:12]; // extract
  /* BRANCH_PRED.vhd:90:6  */
  assign n2111_o = n2088_o ? 2'b01 : n2110_o;
  assign n2112_o = bht[15:14]; // extract
  /* BRANCH_PRED.vhd:90:6  */
  assign n2113_o = n2089_o ? 2'b01 : n2112_o;
  assign n2114_o = bht[17:16]; // extract
  /* BRANCH_PRED.vhd:90:6  */
  assign n2115_o = n2090_o ? 2'b01 : n2114_o;
  assign n2116_o = bht[19:18]; // extract
  /* BRANCH_PRED.vhd:90:6  */
  assign n2117_o = n2091_o ? 2'b01 : n2116_o;
  assign n2118_o = bht[21:20]; // extract
  /* BRANCH_PRED.vhd:90:6  */
  assign n2119_o = n2092_o ? 2'b01 : n2118_o;
  assign n2120_o = bht[23:22]; // extract
  /* BRANCH_PRED.vhd:90:6  */
  assign n2121_o = n2093_o ? 2'b01 : n2120_o;
  assign n2122_o = bht[25:24]; // extract
  /* BRANCH_PRED.vhd:90:6  */
  assign n2123_o = n2094_o ? 2'b01 : n2122_o;
  assign n2124_o = bht[27:26]; // extract
  /* BRANCH_PRED.vhd:90:6  */
  assign n2125_o = n2095_o ? 2'b01 : n2124_o;
  assign n2126_o = bht[29:28]; // extract
  /* BRANCH_PRED.vhd:90:6  */
  assign n2127_o = n2096_o ? 2'b01 : n2126_o;
  assign n2128_o = bht[31:30]; // extract
  /* BRANCH_PRED.vhd:90:6  */
  assign n2129_o = n2097_o ? 2'b01 : n2128_o;
  assign n2130_o = {n2129_o, n2127_o, n2125_o, n2123_o, n2121_o, n2119_o, n2117_o, n2115_o, n2113_o, n2111_o, n2109_o, n2107_o, n2105_o, n2103_o, n2101_o, n2099_o};
endmodule

module mem_wb
  (input  clk,
   input  rst,
   input  [1:0] res_src_m,
   input  reg_write_m,
   input  valid_m,
   input  [4:0] rd_m,
   input  [31:0] pc_plus_4_m,
   input  [31:0] alu_res_m,
   input  [31:0] read_data_m,
   output valid_w,
   output [1:0] res_src_w,
   output reg_write_w,
   output [31:0] read_data_w,
   output [4:0] rd_w,
   output [31:0] pc_plus_4_w,
   output [31:0] alu_res_w);
  wire n870_o;
  wire [1:0] n872_o;
  wire n874_o;
  wire [31:0] n876_o;
  wire [4:0] n878_o;
  wire [31:0] n880_o;
  wire [31:0] n882_o;
  reg n891_q;
  reg [1:0] n892_q;
  reg n893_q;
  reg [31:0] n894_q;
  reg [4:0] n895_q;
  reg [31:0] n896_q;
  reg [31:0] n897_q;
  assign valid_w = n891_q; //(module output)
  assign res_src_w = n892_q; //(module output)
  assign reg_write_w = n893_q; //(module output)
  assign read_data_w = n894_q; //(module output)
  assign rd_w = n895_q; //(module output)
  assign pc_plus_4_w = n896_q; //(module output)
  assign alu_res_w = n897_q; //(module output)
  /* MEM_WB.vhd:37:1  */
  assign n870_o = rst ? 1'b0 : valid_m;
  /* MEM_WB.vhd:37:1  */
  assign n872_o = rst ? 2'b00 : res_src_m;
  /* MEM_WB.vhd:37:1  */
  assign n874_o = rst ? 1'b0 : reg_write_m;
  /* MEM_WB.vhd:37:1  */
  assign n876_o = rst ? 32'b00000000000000000000000000000000 : read_data_m;
  /* MEM_WB.vhd:37:1  */
  assign n878_o = rst ? 5'b00000 : rd_m;
  /* MEM_WB.vhd:37:1  */
  assign n880_o = rst ? 32'b00000000000000000000000000000000 : pc_plus_4_m;
  /* MEM_WB.vhd:37:1  */
  assign n882_o = rst ? 32'b00000000000000000000000000000000 : alu_res_m;
  /* MEM_WB.vhd:35:1  */
  always @(posedge clk)
    n891_q <= n870_o;
  /* MEM_WB.vhd:35:1  */
  always @(posedge clk)
    n892_q <= n872_o;
  /* MEM_WB.vhd:35:1  */
  always @(posedge clk)
    n893_q <= n874_o;
  /* MEM_WB.vhd:35:1  */
  always @(posedge clk)
    n894_q <= n876_o;
  /* MEM_WB.vhd:35:1  */
  always @(posedge clk)
    n895_q <= n878_o;
  /* MEM_WB.vhd:35:1  */
  always @(posedge clk)
    n896_q <= n880_o;
  /* MEM_WB.vhd:35:1  */
  always @(posedge clk)
    n897_q <= n882_o;
endmodule

module ex_mem
  (input  clk,
   input  rst,
   input  [1:0] res_src_e,
   input  mem_write_e,
   input  reg_write_e,
   input  valid_e,
   input  [4:0] rd_e,
   input  [31:0] pc_plus_4_e,
   input  [31:0] alu_res_e,
   input  [31:0] write_data_e,
   output valid_m,
   output [1:0] res_src_m,
   output mem_write_m,
   output reg_write_m,
   output [4:0] rd_m,
   output [31:0] pc_plus_4_m,
   output [31:0] alu_res_m,
   output [31:0] write_data_m);
  wire n828_o;
  wire [1:0] n830_o;
  wire n832_o;
  wire n834_o;
  wire [4:0] n836_o;
  wire [31:0] n838_o;
  wire [31:0] n840_o;
  wire [31:0] n842_o;
  reg n852_q;
  reg [1:0] n853_q;
  reg n854_q;
  reg n855_q;
  reg [4:0] n856_q;
  reg [31:0] n857_q;
  reg [31:0] n858_q;
  reg [31:0] n859_q;
  assign valid_m = n852_q; //(module output)
  assign res_src_m = n853_q; //(module output)
  assign mem_write_m = n854_q; //(module output)
  assign reg_write_m = n855_q; //(module output)
  assign rd_m = n856_q; //(module output)
  assign pc_plus_4_m = n857_q; //(module output)
  assign alu_res_m = n858_q; //(module output)
  assign write_data_m = n859_q; //(module output)
  /* EX_MEM.vhd:39:1  */
  assign n828_o = rst ? 1'b0 : valid_e;
  /* EX_MEM.vhd:39:1  */
  assign n830_o = rst ? 2'b00 : res_src_e;
  /* EX_MEM.vhd:39:1  */
  assign n832_o = rst ? 1'b0 : mem_write_e;
  /* EX_MEM.vhd:39:1  */
  assign n834_o = rst ? 1'b0 : reg_write_e;
  /* EX_MEM.vhd:39:1  */
  assign n836_o = rst ? 5'b00000 : rd_e;
  /* EX_MEM.vhd:39:1  */
  assign n838_o = rst ? 32'b00000000000000000000000000000000 : pc_plus_4_e;
  /* EX_MEM.vhd:39:1  */
  assign n840_o = rst ? 32'b00000000000000000000000000000000 : alu_res_e;
  /* EX_MEM.vhd:39:1  */
  assign n842_o = rst ? 32'b00000000000000000000000000000000 : write_data_e;
  /* EX_MEM.vhd:37:1  */
  always @(posedge clk)
    n852_q <= n828_o;
  /* EX_MEM.vhd:37:1  */
  always @(posedge clk)
    n853_q <= n830_o;
  /* EX_MEM.vhd:37:1  */
  always @(posedge clk)
    n854_q <= n832_o;
  /* EX_MEM.vhd:37:1  */
  always @(posedge clk)
    n855_q <= n834_o;
  /* EX_MEM.vhd:37:1  */
  always @(posedge clk)
    n856_q <= n836_o;
  /* EX_MEM.vhd:37:1  */
  always @(posedge clk)
    n857_q <= n838_o;
  /* EX_MEM.vhd:37:1  */
  always @(posedge clk)
    n858_q <= n840_o;
  /* EX_MEM.vhd:37:1  */
  always @(posedge clk)
    n859_q <= n842_o;
endmodule
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
