uditkalapurakkal/riscv-pipelined-soc-vhdl/(commit log)

2026-05-06 Add OpenLane GDSII implementation reports
    [metrics.csv]
2026-05-06 Organize first OpenLane run reports
    [metrics.csv]
2026-05-06 Add OpenLane GDSII implementation reports into first_run folder
    [metrics.csv]
2026-05-06 Add best CTS clustering optimization reports
    [metrics.csv]
